TobiasBrasileiroReyes/VO2max-Mask/images/arduino v1.1/battery-switch-images (upgrade)/Lipo_battery_glued_in_place.png

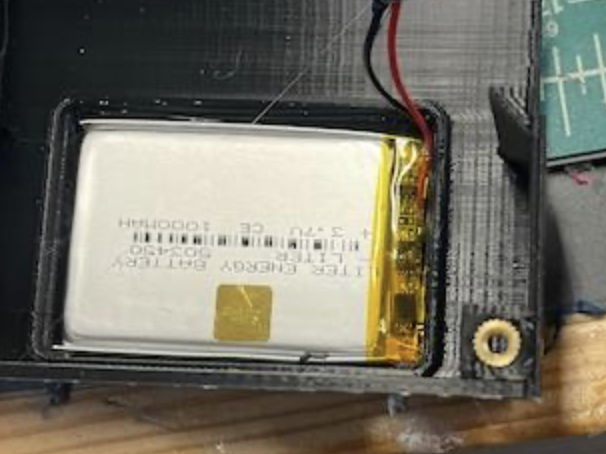
images/arduino v1.1/battery-switch-images (upgrade)/Lipo_battery_glued_in_place.png
