TobiasBrasileiroReyes/VO2max-Mask/images/arduino v1.1/battery-switch-images (upgrade)/wiring_inside_case.png

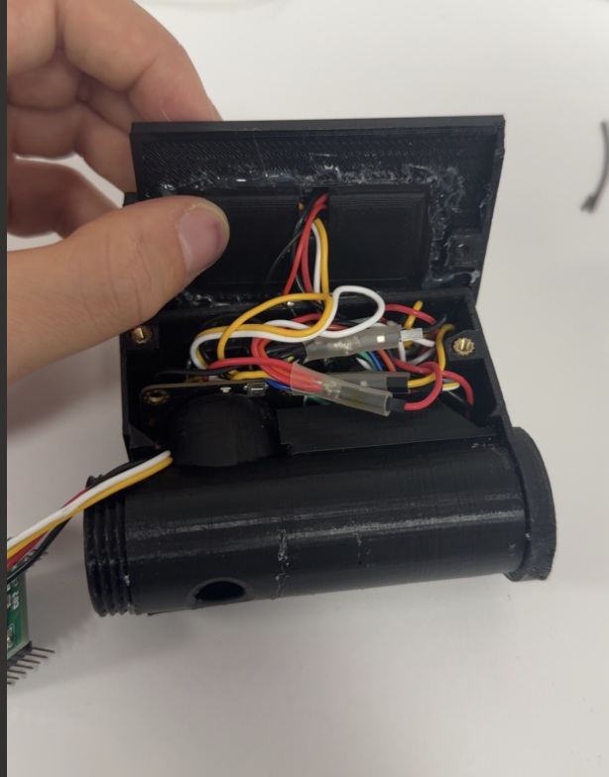
images/arduino v1.1/battery-switch-images (upgrade)/wiring_inside_case.png
