TobiasBrasileiroReyes/VO2max-Mask/(commit log)

2025-12-04 Revise README with project updates and enhancements
    Updated project description, current status, and added hardware upgrade details.
2025-12-04 Rename Skärmavbild 2025-12-04 kl. 15.21.15.png to switch and the button next to display
2025-12-04 Rename Skärmavbild 2025-12-04 kl. 15.23.58.png to upgraded inside
2025-12-04 Revise current status and update date in README
    Updated the current status date and added details about recent work.
2025-12-04 Clarify power-on process instructions in README
    Updated instructions for the power-on process to clarify that the side button resets the screen instead of the system.
2025-12-04 Create battery-switch (upgrade)
2025-12-04 Create switch and side button (reset)
2025-12-04 Rename Skärmavbild 2025-12-04 kl. 17.56.49.png to Lipo_battery_glued_in_place.png
2025-12-04 Rename Skärmavbild 2025-12-04 kl. 15.23.58.png to wiring_inside_case.png
2025-12-04 Simplify power-on process instructions
    Removed redundant phrase from power-on process instructions.
2025-12-09 Rename Skärmavbild 2025-12-09 kl. 14.27.41.png to startup_instructions.png
2025-12-09 Update power-on process and battery charging instructions
    Added instructions for powering on the device and updated image caption.
